simonyiszk/esp8266-g5500-rotator/hardware/main.brd

## EAGLE design hardware/main.brd (2021-03-21)

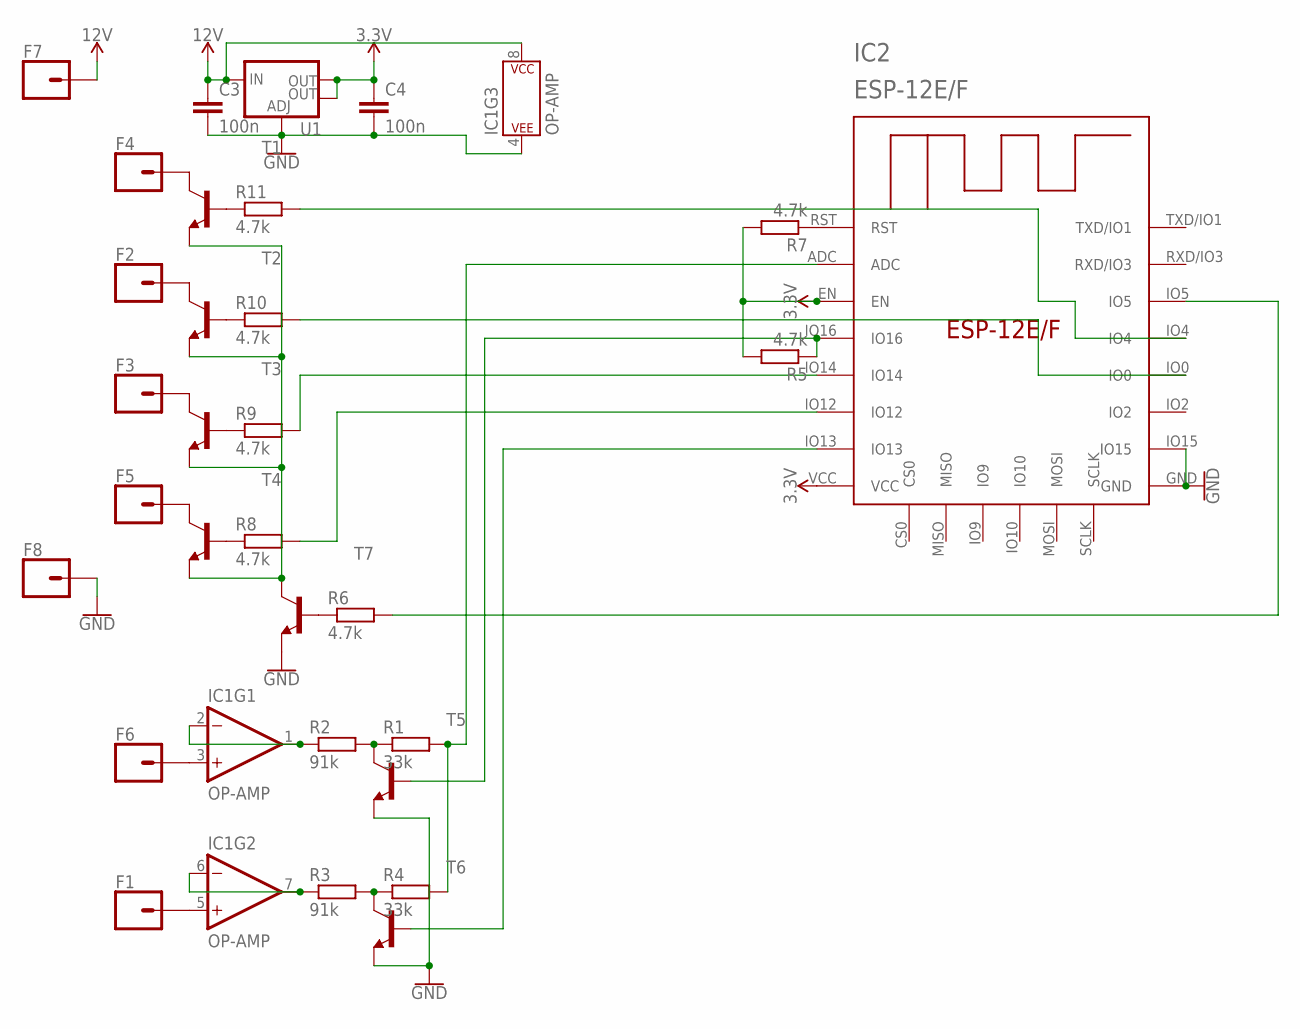
[picture p1: schematic main.sch]

Parts:
C3, C4: 100n; C0805K
F1, F2, F3, F4, F5, F6, F7, F8: CONN_01OFFSET; 1X01_OFFSET
IC1: OP-AMP; SO08
IC2: ESP-12E/F; ESP-12E
R1, R4: 33k; R0805
R2, R3: 91k; R0805
R5, R6, R7, R8, R9, R10, R11: 4.7k; R0805
T1, T2, T3, T4, T5, T6, T7: MMBT5551LT1-NPN-SOT23-BEC; SOT23-BEC
U1: V_REG_LM1117SOT223; SOT223

Connections:
3.3V: C4.1, IC2.EN, IC2.VCC, R5.2, R7.2, U1.2 (OUT), U1.4 (OUT)
12V: C3.1, F7.1, IC1.8 (P$V+), U1.3 (IN)
GND: C3.2, C4.2, F8.1, IC1.4 (P$V-), IC2.GND, IC2.IO15, T5.E, T6.E, T7.E, U1.1 (ADJ)
unnamed: F1.1, IC1.5 (+IN)
unnamed: F4.1, T1.C
unnamed: F2.1, T2.C
unnamed: F5.1, T4.C
unnamed: F3.1, T3.C
unnamed: F6.1, IC1.3 (+IN)
unnamed: T1.E, T2.E, T3.E, T4.E, T7.C
unnamed: R6.1, T7.B
unnamed: IC2.IO0, R10.2
unnamed: R1.1, R2.2, T5.C
unnamed: IC1.1 (OUT), IC1.2 (-IN), R2.1
unnamed: R3.2, R4.1, T6.C
unnamed: IC1.6 (-IN), IC1.7 (OUT), R3.1
unnamed: IC2.ADC, R1.2, R4.2
unnamed: IC2.IO4, R11.2
unnamed: IC2.IO5, R6.2
unnamed: R8.1, T4.B
unnamed: IC2.IO12, R8.2
unnamed: IC2.IO13, T6.B
unnamed: IC2.IO16, R5.1, T5.B
unnamed: IC2.RST, R7.1
unnamed: R9.1, T3.B
unnamed: R10.1, T2.B
unnamed: R11.1, T1.B
unnamed: IC2.IO14, R9.2

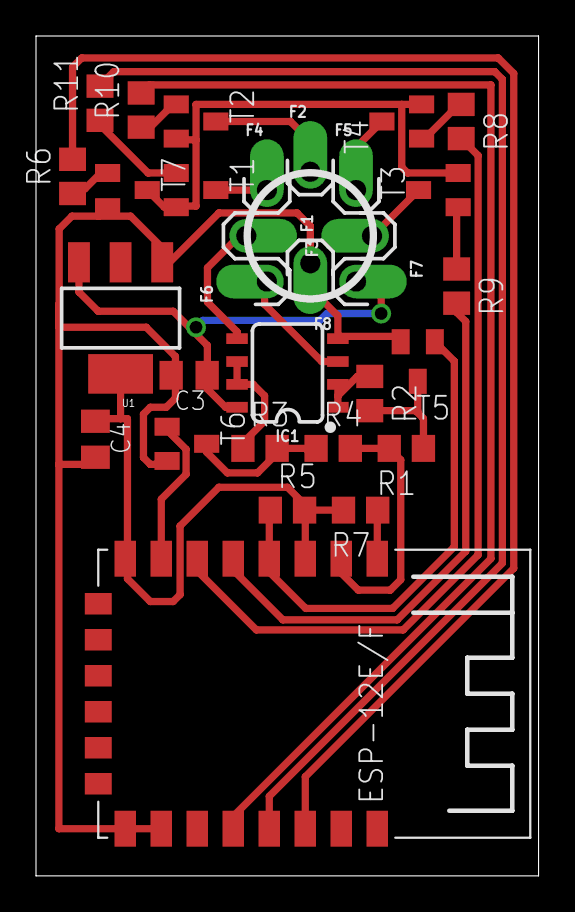
[picture p2: board main.brd from above]

Board: 2 copper layers, 27.9 x 46.7 mm, 31 parts (0 on the bottom side), 28 nets.
